Xsento/esp32-digital-setting-circles/3D/internalSupport.stl

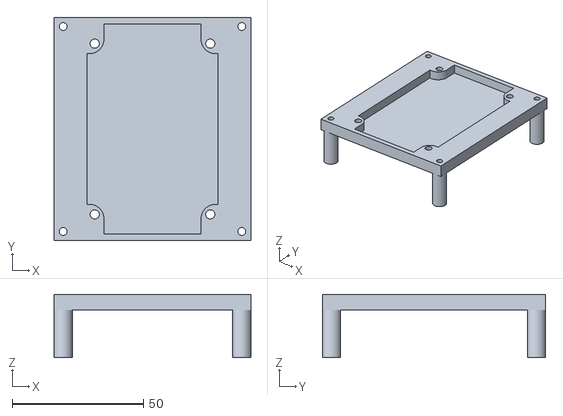
[picture p1: CAD file, 2026-10-18]
3D/internalSupport.stl
75.0 x 85.0 x 24.0
