Xsento/esp32-digital-setting-circles/3D/dovetailAdapter.stl

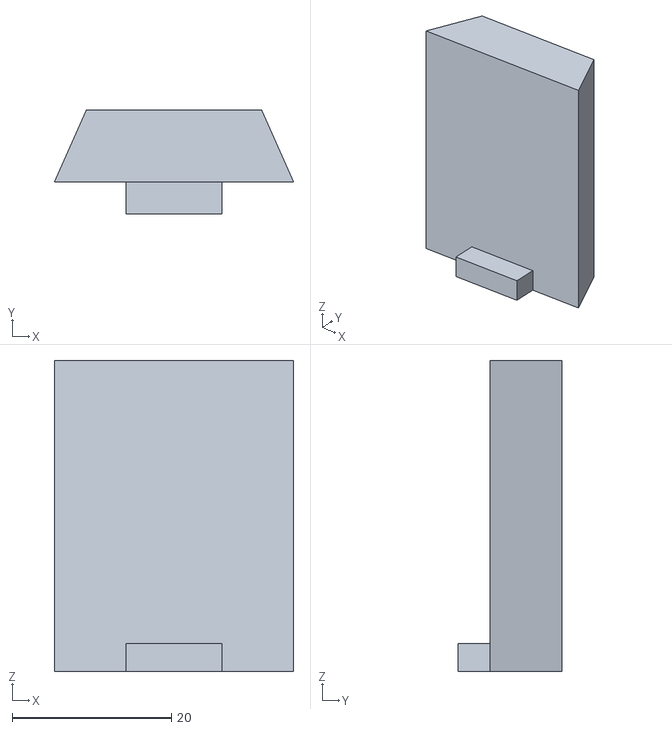
[picture p2: CAD file, 2026-10-18]
3D/dovetailAdapter.stl
30.0 x 13.0 x 39.0
