Xsento/esp32-digital-setting-circles/3D/boxMount.stl

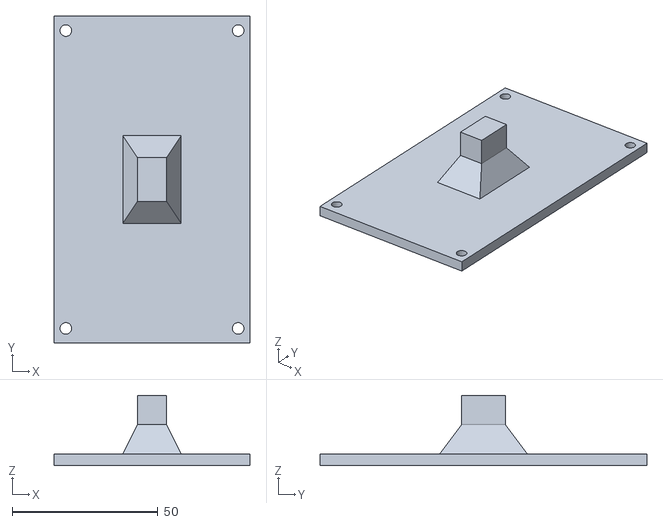
[picture p3: CAD file, 2026-10-18]
3D/boxMount.stl
67.0 x 112.0 x 24.0
