Xsento/esp32-digital-setting-circles/docs/schematic.pdf

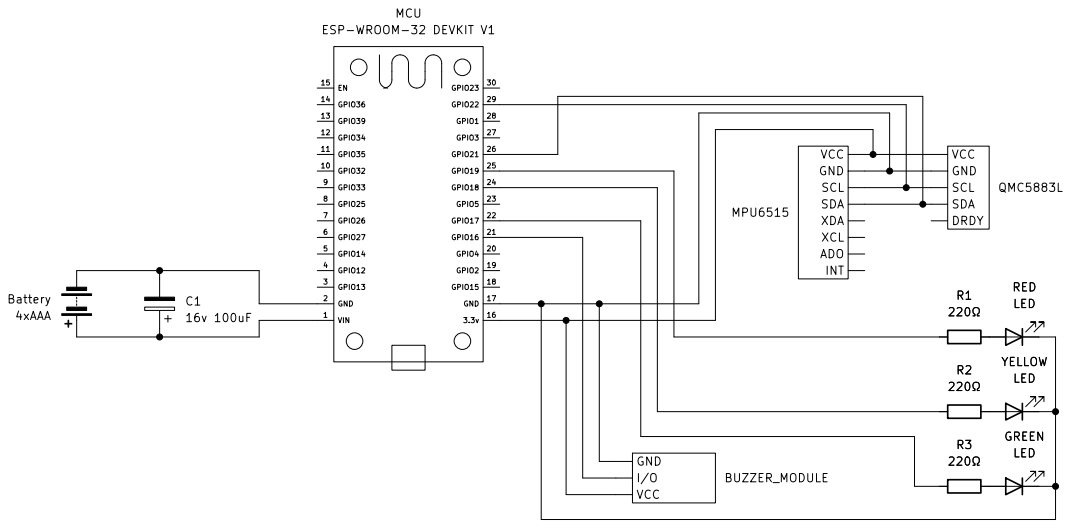
[picture p4: page 1]

SCL SDA XDA XCL ADO
