Xsento/esp32-digital-setting-circles/docs/schematic.kicad_sch

## KiCad design docs/schematic.kicad_sch (2026-10-18)

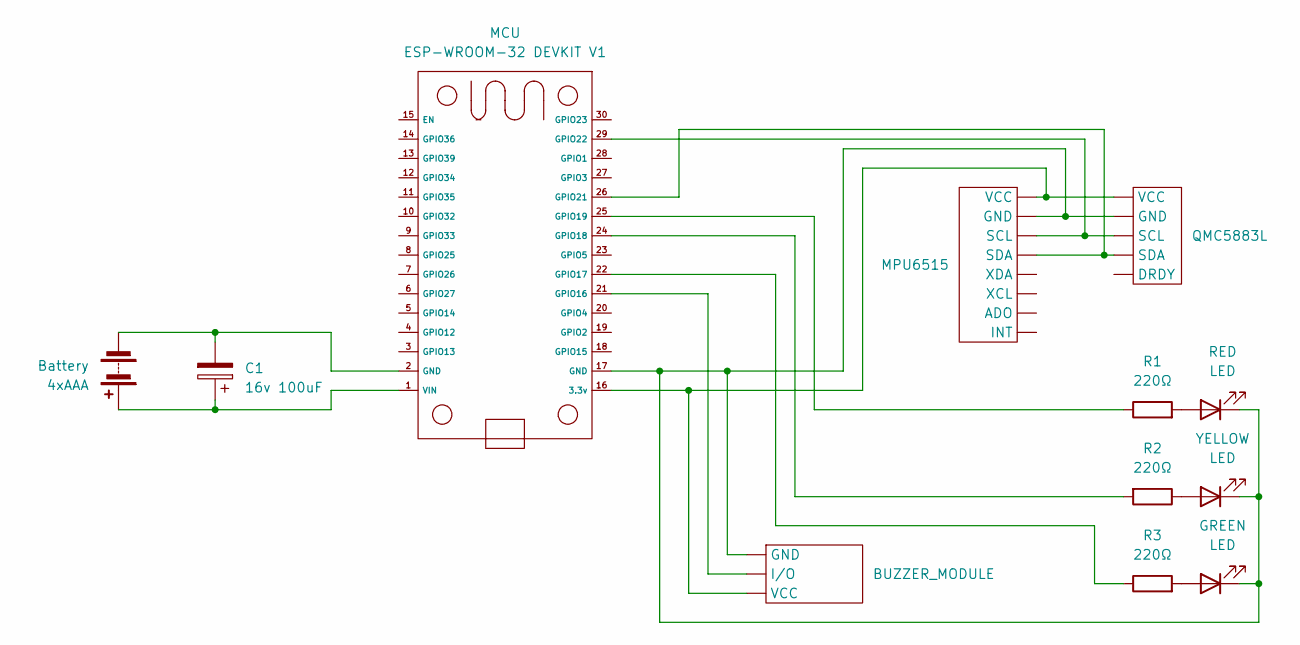
[picture p5: schematic schematic.kicad_sch]

Parts:
4xAAA: Battery
BUZZER_MODULE: (no value)
C1: 16v 100uF
GREEN: LED
MCU: ESP-WROOM-32 DEVKIT V1
MPU6515: (no value)
QMC5883L: (no value)
R1, R2, R3: 220Ω
RED: LED
YELLOW: LED

Connections:
unnamed: 4xAAA.1 (+), C1.1, MCU.1 (VIN)
unnamed: 4xAAA.2 (-), C1.2, MCU.2 (GND)
unnamed: BUZZER_MODULE., GREEN.1 (K), MCU.16 (3.3v), MCU.17 (GND), MCU.21 (GPIO16), MPU6515., QMC5883L., RED.1 (K), YELLOW.1 (K)
unnamed: GREEN.2 (A), R3.2
unnamed: MCU.22 (GPIO17), R3.1
unnamed: MCU.24 (GPIO18), R2.2
unnamed: MCU.25 (GPIO19), R1.1
unnamed: MCU.26 (GPIO21), MPU6515., QMC5883L.
unnamed: MCU.29 (GPIO22), MPU6515., QMC5883L.
unnamed: R1.2, RED.2 (A)
unnamed: R2.1, YELLOW.2 (A)
